xiaodi112/----home--valve/Pressure_Regulating_Box/Projects/Wakeup_box_V0.0.1/readme.txt

/*!
    \file    readme.txt
    \brief   description of the LPUART wakeup from deepsleep

    \version 2025-08-21, V2.5.0, demo for GD32L23x
*/

/*
    Copyright (c) 2025, GigaDevice Semiconductor Inc.

    Redistribution and use in source and binary forms, with or without modification,
are permitted provided that the following conditions are met:

    1. Redistributions of source code must retain the above copyright notice, this
       list of conditions and the following disclaimer.
    2. Redistributions in binary form must reproduce the above copyright notice,
       this list of conditions and the following disclaimer in the documentation
       and/or other materials provided with the distribution.
    3. Neither the name of the copyright holder nor the names of its contributors
       may be used to endorse or promote products derived from this software without
       specific prior written permission.

    THIS SOFTWARE IS PROVIDED BY THE COPYRIGHT HOLDERS AND CONTRIBUTORS "AS IS"
AND ANY EXPRESS OR IMPLIED WARRANTIES, INCLUDING, BUT NOT LIMITED TO, THE IMPLIED
WARRANTIES OF MERCHANTABILITY AND FITNESS FOR A PARTICULAR PURPOSE ARE DISCLAIMED.
IN NO EVENT SHALL THE COPYRIGHT HOLDER OR CONTRIBUTORS BE LIABLE FOR ANY DIRECT,
INDIRECT, INCIDENTAL, SPECIAL, EXEMPLARY, OR CONSEQUENTIAL DAMAGES (INCLUDING, BUT
NOT LIMITED TO, PROCUREMENT OF SUBSTITUTE GOODS OR SERVICES; LOSS OF USE, DATA, OR
PROFITS; OR BUSINESS INTERRUPTION) HOWEVER CAUSED AND ON ANY THEORY OF LIABILITY,
WHETHER IN CONTRACT, STRICT LIABILITY, OR TORT (INCLUDING NEGLIGENCE OR OTHERWISE)
ARISING IN ANY WAY OUT OF THE USE OF THIS SOFTWARE, EVEN IF ADVISED OF THE POSSIBILITY
OF SUCH DAMAGE.
*/

  This example is based on the GD32L233R-EVAL-V1.1 board, it shows how to use the LPUART
to wake up the MCU from deepsleep mode.
  In this demo, the wake up method is configured as start bit detection. When the MCU
enters into deepsleep mode, the LED1 stops in a certain status(on or off). In this 
case, you can send some characters to wake up LPUART and the LED1 blinks.
