xiaodi112/----home--valve/docs/工程架构整理.md

# 工程架构整理与改动指南

> 适用工程：`Pressure_Regulating_Box`（GD32L233RC，Keil MDK）
> 最后更新：2026-08-28（对应激光甲烷/定时开关阀/三组独立 I2C 重构后的代码状态）

---

## 1. 总体架构

### 1.1 分层与依赖方向

```
App（业务层：不碰寄存器/外设）
  │  只调用 Middle 接口 与 BSP 语义接口
  ▼
Middle（中间层：业务编排、协议、配置、上报）
  │  调用 Drivers / BSP
  ▼
Drivers（外设驱动：通信/传感器/存储传输）
  │  调用 BSP（延时、串口、电源）
  ▼
BSP（板级驱动：GPIO/电源/电机/LCD/深睡，自包含、零业务依赖）
```

**强制约定**：
- App 层不得出现 `gpio_*`、`rcu_*`、`pwm_*` 直接调用（main.c 启动段除外）。
- BSP 层不得 include Middle/App 头文件、不得引用业务全局变量。
- 平台 JSON 组包只能出现在 `Middle/report.c`。
- 各层向下依赖，禁止反向。

### 1.2 目录与模块职责

#### App（业务层）

| 模块 | 职责 | 说明 |
|---|---|---|
| `valve.c/h` | 阀门业务：开/关/状态查询、到位超时、压紧延时、状态持久化 | 只调 motor 语义接口，无 GPIO |
| `lcd_ui.c/h` | LCD 页面/图标、蓝牙开关 | 蓝牙电源走 `power_ble_set()` |
| `buzzer.c/h` | 蜂鸣器提示音 | 调 output API |
| `led.c/h` | LED 指示 | 调 output API |

#### Middle（中间层）

| 模块 | 职责 |
|---|---|
| `main.h` | 主模块接口：`g_sensor`、`lcd_shutdown`、`alarm_try_close_valve` |
| `report.c/h` | **统一上报唯一出口**：`report_publish_field/feedback/ip_field/sensor_status/upload_summary`、`report_query_signal_info` |
| `downlink.c/h` | 下行指令：`parse_cmd` 解析 + `s_cmd_handlers` 表驱动分发；对外仅 `drain_pending_downlink()` |
| `eeprom_config.h` | 配置门面头：EEPROM 地址、结构体、全局 extern、接口声明 |
| `config_store.c/h` | 配置持久化：EE 读写、`config_load_all`、`config_save_*`；**全局 g_\* 定义归属** |
| `config_policy.c/h` | 配置纯策略：dottime 位图、周期/异常转换、窗口/采集决策 |
| `eeprom_config.c` | 配置 CLI：串口命令解析、上电配置等待、配置打印 |
| `app_config.h` | 编译期业务默认值（周期/窗口/阈值/协议参数、IIC0/1/2 总线映射） |
| `threshold.c/h` | 阈值判断（纯业务，只读配置结构体） |
| `valve_timing.c/h` | 定时开关阀时间匹配（纯逻辑，无硬件依赖；closeoropen_set/get） |
| `ch4_alarm.c/h` | 激光甲烷状态机（`do_ch4()` 入口）+ 阈值判断 |
| `json_builder.c/h` | 轻量 JSON 构建器 |
| `ota_app.c/h` | OTA 应用流程（4G 下载→缓存→InfoBlock→重启） |
| `eeprom_history.c/h` | 历史数据存取 |
| `sensor_record.h` / `ota_info.h` | 数据/Flash 布局定义 |

#### BSP（板级驱动，自包含）

| 模块 | 职责 | 关键接口 |
|---|---|---|
| `power.c/h` | 电源管理：4G_EN、BLE_EN、传感器供电(SENSOR_PWR PC3)、CH4_PWR(PC13)、DTR | `power_gpio_init`、`power_4g_set/is_on`、`power_ble_set`、`power_sensor_set`、`power_ch4_set/is_on`、`power_4g_dtr_set` |
| `output.c/h` | 蜂鸣器/LED 输出 | `output_gpio_init`、`output_buzzer_set`、`output_led_set/is_on` |
| `motor.c/h` | 电机：限位、方向、使能、引脚宏(`MOTOR_ENABLED=0` 时空实现) | `motor_init(enabled)`、`motor_drive_open/close`、`motor_stop`、`motor_limit1/2_reached`、`motor_sleep_enable/disable` |
| `usart.c/h` | USART0(Debug)/USART1(CH4)/LPUART0(4G)/UART4(BLE)：初始化、DMA、打印 | `printf_debug`、`debug_rx_read_line`、`com_lpuart_init`、`usart1_ch4_init/deinit`、`ble_uart_init` |
| `wakeup.c/h` | 深睡入口/唤醒重初始化 | `enter_deepsleep_mode(PmSleepCfg_t*)`、`system_wakeup_reinit` |
| `mygpio.c/h` | GPIO 初始化、按键 EXTI、低功耗引脚归位、唤醒源 | `gpio_init`、`gpio_enter_low_power(lpuart,lcd,bt)`、`button_*`、`ble_exti_*`、`ri_exti_*` |
| `tim.c/h` | RTC 时间/闹钟 | `rtc_get_hhmmss`、`rtc_set_next_alarm_sec` |
| `delay.c/h` | 延时 + 软件看门狗 | `trea_delay_ms`、`trea_millis`、`swdt_enable/disable` |
| `systick.c/h` | 系统滴答 | — |
| `adc_bat.c/h` | 电池电压 | `adc_bat_read_voltage` |
| `slcd_seg.c/h` | 段码 LCD 底层 + 关屏释放引脚 | `slcd_seg_*`、`slcd_shutdown` |

#### Drivers（外设驱动，**仍待净化**）

| 模块 | 职责 | 遗留问题（主题 B） |
|---|---|---|
| `soft_i2c.c/h` | 软件 I2C（三组独立总线 IIC0=PB6/7 EEPROM、IIC1=PD4/5 S2、IIC2=PC0/1 S1）+ 传感器供电调用 | 引脚宏仍来自 app_config.h（IIC0/1/2 宏） |
| `ec800e.c/h` | 4G AT/MQTT/HTTP | 仍含 FastBee JSON、`FullUpload` 编排、依赖业务头 |
| `ble_ota.c/h` | BLE OTA 协议 | 仍含 `YLY_<ID>` 名称配置等业务 |
| `PT_304_35.c/h` | 压力/温度传感器（S1=低压/出气→IIC2，S2=中压/进气→IIC1） | — |
| `ch4_sensor.c/h` | 激光甲烷传感器驱动（USART1，独立、可移植、零上层依赖） | — |
| `m24m01.c/h`、`at24c64.c/h` | EEPROM 芯片驱动（当前启用 AT24C64，走 IIC0 PB6/7 独立总线） | — |

#### 顶层

| 文件 | 职责 |
|---|---|
| `Projects/.../main.c` | 主状态机编排、启动初始化、休眠/唤醒、4G 策略、调试命令 |
| `Projects/.../gd32l23x_it.c` | 中断服务（仅置唤醒标志，不处理业务） |
| `Bootloader/boot_main.c` | 启动引导 + OTA 搬运 |

---

## 2. 核心设计约定

### 2.1 主状态机（main.c）

```
STATE_INIT → STATE_SLEEP → STATE_WAKEUP ─┬→ STATE_COLLECT → STATE_UPLOAD
                  ↑                       ├→ STATE_DOWNLINK
                  │                       ├→ STATE_ALARM
                  │                       ├→ STATE_BLE_OTA
                  │                       └→ STATE_CH4
                  └─────────────────────────────────────────┘
```

- 深睡：`wakeup.c` 统一入口，唤醒源 = RTC 闹钟 / LPUART / 按键 EXTI / 4G RI。
- 入睡前由 main.c 组装 `PmSleepCfg_t{lpuart_enabled, lcd_active, bt_on}` 传给 BSP，BSP 不读全局。
- `STATE_CH4`：激光甲烷采集,由 `g_ch4_request`(`gas_get` 触发)或 `laser_time` 位图命中整点时,在主循环 `STATE_SLEEP` 分支转入;不抢占网格采集/整点上报。

### 2.2 下行指令流程（downlink.c）

```
EC801E_ReadDownlink → parse_cmd(raw, &req)
   ├─ OTA（含 downloadUrl）→ ota_app_handle_upgrade_cmd
   ├─ 格式B（commandStr）→ CmdMap 映射为 id
   └─ 格式A（id/value）
        ↓
s_cmd_handlers 表（44 项，含 gas_get/laser_get/laser_set/msh_get/msh_set/closeoropen_*/table_*）→ h_xxx(id_val, cmd_val, raw_buf)
        ↓
report_publish_*（反馈/响应）
```

`s_cmd_map`（commandStr → id 映射）当前 47 项；`s_cmd_handlers`（id → handler 分发）当前 44 项。

### 2.3 上报（report.c）

- 平台 JSON 组包唯一出口，`EC801E_PublishRawJson` 只被 report.c 直接调用（驱动内部除外）。
- 模块内共享 1KB 缓冲 + 32B 时间戳，函数串行使用、禁止嵌套。

### 2.4 配置（eeprom_config.h 门面 + 三实现文件）

- **数据**：地址/magic/结构体/全局 extern/接口声明 → `eeprom_config.h`
- **持久化**：`config_store.c`（全局 g_\* 定义 + 读写 + load/save，含 `config_save_valve_timing/ch4_threshold/laser`）
- **策略**：`config_policy.c`（纯逻辑，无 EEPROM/串口）
- **CLI**：`eeprom_config.c`（串口解析 + 上电等待）

EEPROM 区块新增：定时开关阀(0xC8/0x490)、CH4 阈值(0xC9/0x4B0)、激光定时采集(0xCA/0x4C0)。芯片由 `app_config.h` 编译宏二选一(当前 `EEPROM_DRV_AT24C64` 8KB)，均走 IIC0(PB6/7)独立总线。

### 2.5 编码规则（重要）

- 工作区 `.c/.h` 为 **GBK**；入库时经 `.gitattributes`（`working-tree-encoding=GBK`）自动转 UTF-8。
- `docs/*.md` 为 UTF-8。
- 修改 `.c/.h` 时：若文件含中文注释，编辑后必须保持 GBK（可用 GBK→UTF-8 编辑→转回，或字节级 ASCII 替换）；`git diff` 若显示中文乱码说明编码被破坏。
- 新文件同样要转 GBK（纯 ASCII 内容则两种编码等价）。

### 2.6 低功耗

- 深睡路径统一走 `enter_deepsleep_mode()`：清唤醒标志 → 关软狗 → `gpio_enter_low_power`（未用引脚全 Analog）→ PMU 深睡 → 等唤醒源。
- 4G 省电：QSCLK/DTR（power.c）；弱信号自动断电（main.c 策略）。

---

## 3. 日常改动指南

### 3.1 新增一条 MQTT 下行指令

1. （格式B）在 `downlink.c` 的 `s_cmd_map` 增加 `commandStr → id` 映射；若平台用格式A（id/value），跳过此步。
2. 在 `downlink.c` 写 handler：
   ```c
   static void h_my_cmd(const char *id_val, const char *cmd_val, const char *raw_buf)
   {
       /* 业务逻辑；参数/响应用 report_publish_* */
   }
   ```
3. 在 `s_cmd_handlers[]` 登记：`{ "my_id", h_my_cmd },`（格式A 的 id 直接命中；格式B 经 CmdMap 归一后命中）。
4. 反馈用 `report_publish_feedback(码)`，单字段响应用 `report_publish_field/response`。
5. 编译 + 用平台下发验证。

### 3.2 新增/修改上报字段

- 只改 `Middle/report.c`（字段名、格式、缓冲）。
- 若需要新上报函数，加到 `report.h` 并保持"串行使用共享缓冲"约定。

### 3.3 新增配置项

1. 结构体字段：`eeprom_config.h`（配置结构体）。
2. 存储布局：`eeprom_config.h` 增加地址宏 + magic（注意区域不重叠）。
3. 读写：`config_store.c` 的 `config_load_all` / `config_save_*`。
4. 默认值：`app_config.h` 或 `eeprom_config.h` 的 `DEF_*`。
5. CLI 解析：`eeprom_config.c` 的 `parse_*` / `config_parse_and_apply`。
6. 平台指令：按 3.1 流程加 handler。

### 3.4 新增 BSP 模块 / 改引脚

- 引脚宏定义在**模块自己的头文件**（如 motor.h、power.h），不要放 app_config.h。
- BSP 模块不得 include Middle/App 头；需要的状态由调用方传参。
- 新增 `.c/.h` 后必须在 Keil 工程 `GD32L233R_EVAL.uvprojx` 对应组登记。

### 3.5 修改电机/LCD/4G 行为

- 电机：只改 `BSP/motor.c`（语义接口内部）；`App/valve.c` 不感知 PWM/GPIO 差异。
- LCD：显示逻辑在 `App/lcd_ui.c`，底层/关屏在 `BSP/slcd_seg.c`。
- 4G 电源/休眠：`BSP/power.c` + `main.c` 策略；AT/协议在 Drivers（待主题 B 拆分）。

---

## 4. 已完成重构记录

| 批次 | 内容 | 验证 |
|---|---|---|
| 1 | motor 语义接口 + valve 去寄存器；pwm_compute/占空比钳制/关阀停车修复 | 构建 0/0 |
| 2 | 新增 power/output/wakeup；业务层去 GPIO；mygpio/usart 去业务全局；板级宏归位 | 构建 0/0 |
| 3 | report.c 统一上报，消灭 main/downlink 重复组包 | 构建 0/0，省 736B RAM |
| 4 | downlink 表驱动（36 handler + 39 表项）；parse_cmd 统一解析去 hack；eeprom_config 三拆 | 构建 0/0 |
| 5 | 激光甲烷传感器(ch4_sensor/ch4_alarm + STATE_CH4 + USART1/PC13)；定时开关阀(valve_timing + EEPROM 0xC8)；三组独立 I2C(IIC0=PB6/7 EEPROM / IIC1=PD4/5 S2 / IIC2=PC0/1 S1) + PC3 传感器供电；EEPROM 切换 AT24C64；downlink 表增至 47 map/44 handler | 构建 0/0 |

---

## 5. 已知遗留问题（待办）

| 主题 | 问题 | 建议 |
|---|---|---|
| B | `ec800e.c` 仍混业务：FastBee JSON、`FullUpload` 编排、依赖 `eeprom_config/threshold/main` 头 | 拆 `ec_at` 传输层 + MQTT 客户端，JSON 组包并入 report.c |
| B | `ble_ota.c` 含 `YLY_<ID>` 名称配置业务 | 业务参数化上移 |
| E | `g_sensor` 等全局仍跨模块共享 | 收敛到 `sensor.c` 模块 + 接口函数 |
| F | downlink 各 handler 内 300ms 延时、`first_ip_set` 重连阻塞 | 反馈并入回复 JSON / 下轮补发；重连异步化 |
| F | 阀门 20s 阻塞等待（**用户已搁置，需另行通知**） | 限位轮询 + 超时状态机 |
| — | IIC0/1/2 引脚宏仍定义在 `app_config.h`（soft_i2c.h / at24c64.h / PT_304_35.h 依赖） | 后续移入 BSP 板级头 |
| — | `report_publish_upload_summary` 的 `user_state` 静态标志（用户 MQTT 凭据仅首次上报） | 确认语义或改为配置版本号触发 |
| ✓ | `docs/project.md` §12 文件结构(旧 my_Library 时代) | 已于 2026-08-28 按 App/Middle/BSP/Drivers 四层重写 |

---

## 6. 构建与验证

### 6.1 命令行构建（Keil UV4）

```powershell
& 'D:/keil/core/UV4/UV4.exe' -b "Pressure_Regulating_Box/Projects/Wakeup_box_V0.0.1/MDK-ARM/GD32L233R_EVAL.uvprojx" -o build.log -j0
```

要求：**0 Error / 0 Warning**；关注 `Program Size` 的 `ZI-data`（SRAM 用量）。

### 6.2 回归清单（入口）

- 串口命令：`status / sensor / sim / config / valve:open / valve:close / threshold_get / restart / reset` 等（详见 `docs/project.md` §8）。
- 平台下发：查询/设置指令 + feedback 码核对。
- 专项：深睡唤醒、定时阀、异常关阀、OTA、功耗。

### 6.3 提交规范

- 分支前缀 `codex/`；一个主题一个 commit；每个 commit 必须可编译。
- message 沿用仓库风格：`feat/fix/refactor + 中文摘要 + 动机/影响正文`。
- 提交前检查 `git diff` 无编码乱码。

---

## 7. 快速索引

- 主流程/状态机：`Projects/Wakeup_box_V0.0.1/main.c`
- 平台上报格式：`Middle/report.c`
- 下行指令表：`Middle/downlink.c`（`s_cmd_map` + `s_cmd_handlers`）
- 配置存储布局：`Middle/eeprom_config.h`；持久化 `config_store.c`；策略 `config_policy.c`；CLI `eeprom_config.c`
- 引脚：`BSP/power.h`、`BSP/output.h`、`BSP/motor.h`、`Middle/app_config.h`（IIC）、`docs/引脚使用情况说明.md`
- 深睡/唤醒：`BSP/wakeup.c`
