xiaodi112/----home--valve/Pressure_Regulating_Box/LCD.png

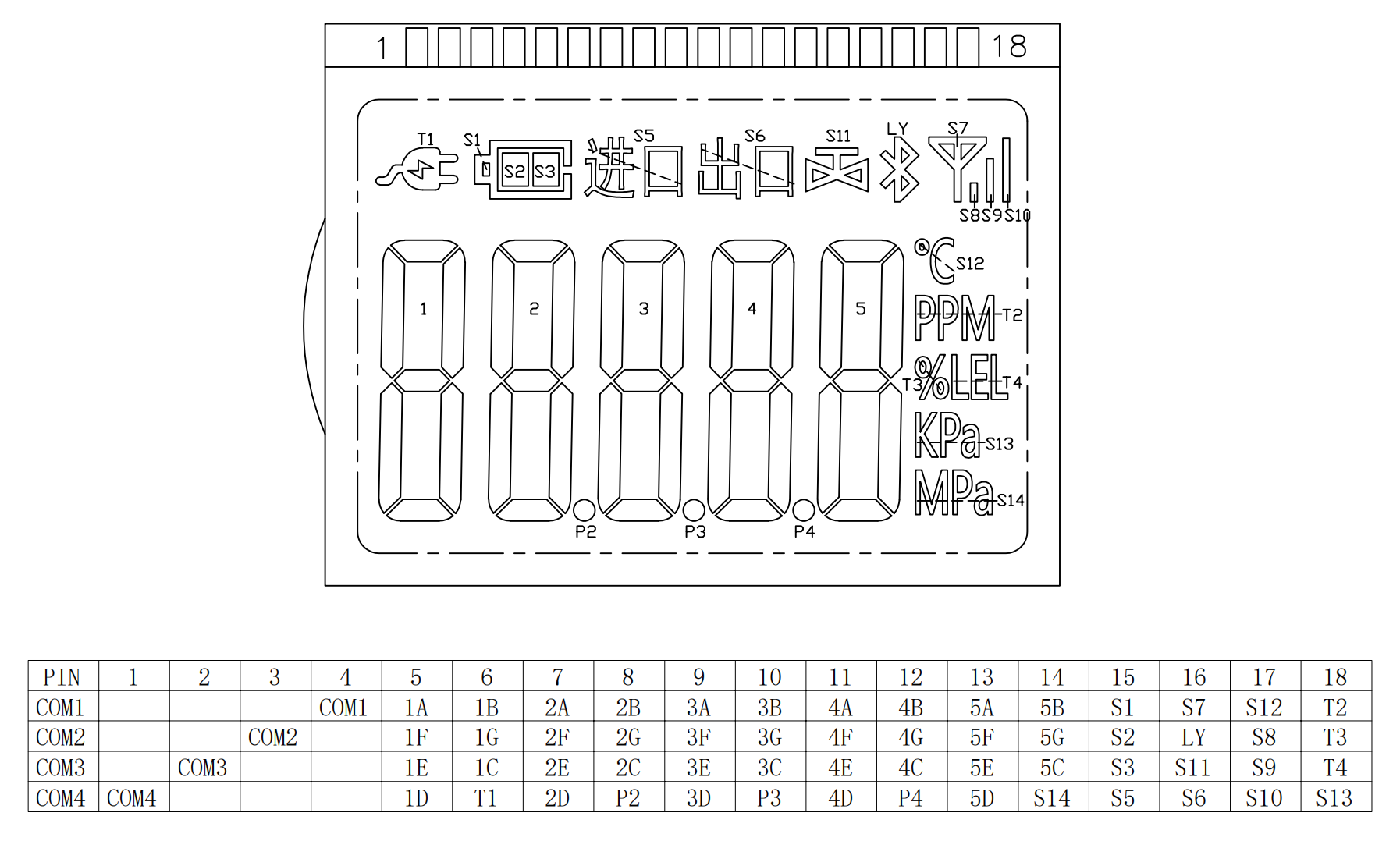
Pressure_Regulating_Box/LCD.png
