xiaodi112/----home--valve/Pressure_Regulating_Box/数据交互.png

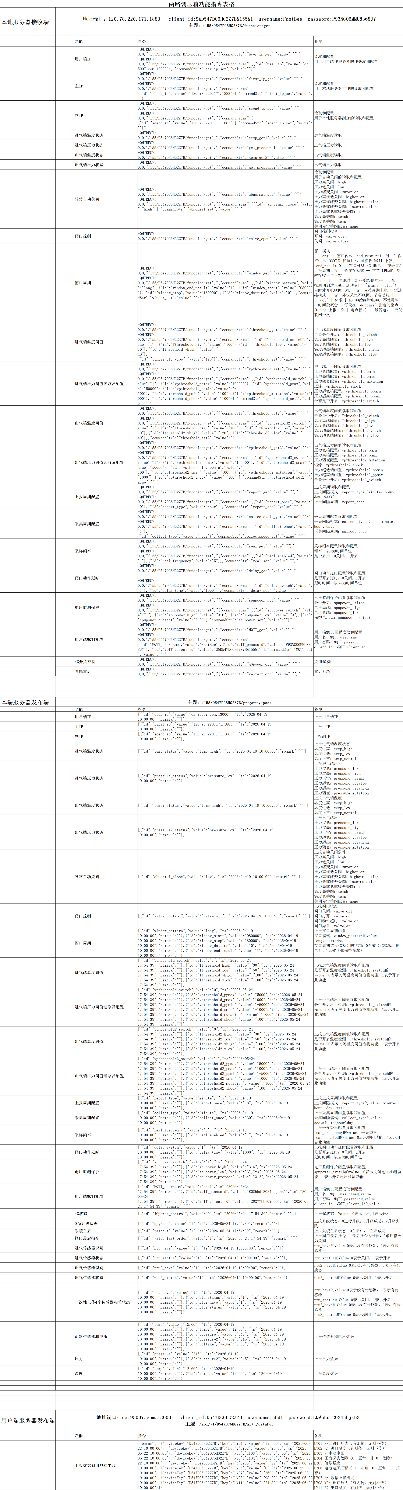
Pressure_Regulating_Box/数据交互.png
