xiaodi112/----home--valve/Pressure_Regulating_Box/电路图.png

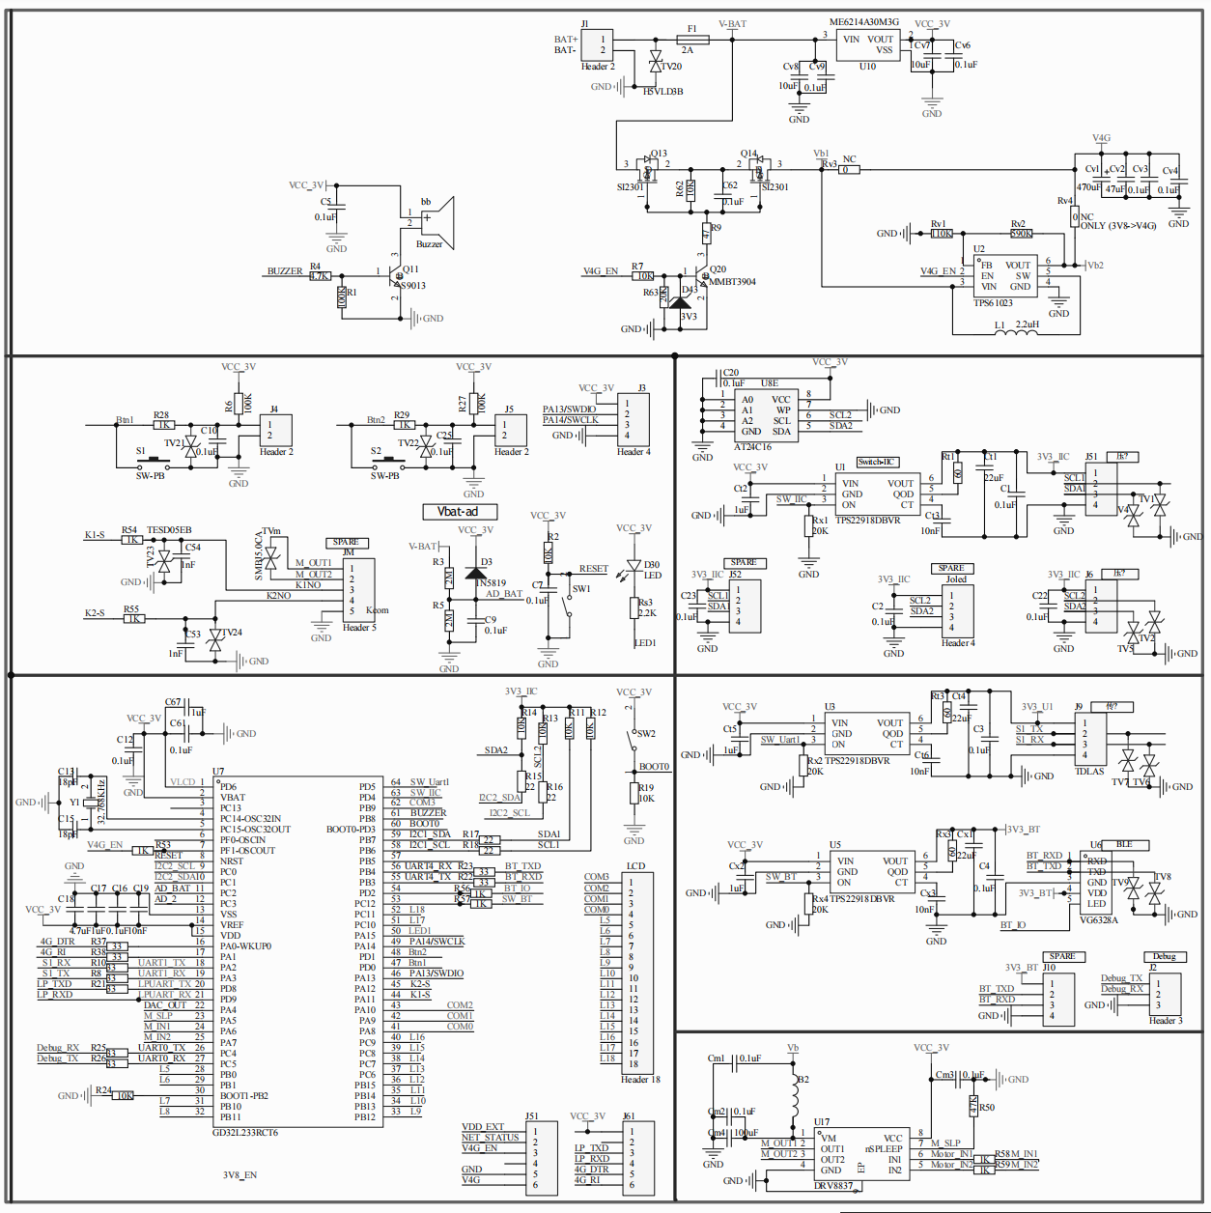
Pressure_Regulating_Box/电路图.png
