xiaodi112/----home--valve/Household_valves_LPUART_OTA/Projects/07_LPUART_Deepsleep_Wakeup/MDK-ARM/build_log.txt

*** Using Compiler 'V6.24', folder: 'D:\keil\core\ARM\ARMCLANG\Bin'
Rebuild target 'GD32L233R_EVAL'
compiling system_gd32l23x.c...
compiling gd32l23x_it.c...
compiling main.c...
compiling systick.c...
compiling boot_main.c...
compiling app_vectors.c...
compiling gd32l23x_cau_tdes.c...
compiling gd32l23x_cau_des.c...
compiling i2c_cz.c...
compiling gd32l23x_cau.c...
compiling gd32l23x_cau_aes.c...
compiling gd32l23x_adc.c...
compiling gd32l23x_crc.c...
compiling gd32l23x_cmp.c...
compiling gd32l23x_ctc.c...
compiling gd32l23x_dac.c...
compiling gd32l23x_dbg.c...
compiling gd32l23x_exti.c...
compiling gd32l23x_fwdgt.c...
compiling gd32l23x_gpio.c...
compiling gd32l23x_lptimer.c...
compiling gd32l23x_dma.c...
compiling gd32l23x_fmc.c...
compiling gd32l23x_i2c.c...
compiling gd32l23x_misc.c...
compiling gd32l23x_lpuart.c...
compiling gd32l23x_pmu.c...
compiling gd32l23x_rcu.c...
compiling gd32l23x_rtc.c...
assembling startup_gd32l233.s...
compiling gd32l23x_slcd.c...
compiling gd32l23x_syscfg.c...
compiling gd32l23x_trng.c...
compiling gd32l23x_spi.c...
compiling gd32l23x_vref.c...
compiling gd32l23x_wwdgt.c...
compiling gd32l233r_eval.c...
compiling gd32l23x_usart.c...
compiling gd32l23x_timer.c...
compiling ec800e.c...
compiling usart.c...
compiling delay.c...
compiling tim.c...
compiling AT24c16.c...
compiling sensor_buffer.c...
compiling mygpio.c...
compiling PT_304_35.c...
compiling motor.c...
compiling myi2c.c...
compiling adc_bat.c...
compiling ota.c...
compiling threshold.c...
compiling eeprom_config.c...
linking...
Program Size: Code=58318 RO-data=14082 RW-data=12 ZI-data=22636  
FromELF: creating hex file...
".\Objects\Project.axf" - 0 Error(s), 0 Warning(s).
Build Time Elapsed:  00:00:03
