xiaodi112/----home--valve/Pressure_Regulating_Box/change log.txt

/*!
    \file    change log.txt
    \brief   change log for GD32L23x demo

    \version 2025-08-21, V2.5.0, demo for GD32L23x
*/

/*
    Copyright (c) 2025, GigaDevice Semiconductor Inc.

    Redistribution and use in source and binary forms, with or without modification,
are permitted provided that the following conditions are met:

    1. Redistributions of source code must retain the above copyright notice, this
       list of conditions and the following disclaimer.
    2. Redistributions in binary form must reproduce the above copyright notice,
       this list of conditions and the following disclaimer in the documentation
       and/or other materials provided with the distribution.
    3. Neither the name of the copyright holder nor the names of its contributors
       may be used to endorse or promote products derived from this software without
       specific prior written permission.

    THIS SOFTWARE IS PROVIDED BY THE COPYRIGHT HOLDERS AND CONTRIBUTORS "AS IS"
AND ANY EXPRESS OR IMPLIED WARRANTIES, INCLUDING, BUT NOT LIMITED TO, THE IMPLIED
WARRANTIES OF MERCHANTABILITY AND FITNESS FOR A PARTICULAR PURPOSE ARE DISCLAIMED.
IN NO EVENT SHALL THE COPYRIGHT HOLDER OR CONTRIBUTORS BE LIABLE FOR ANY DIRECT,
INDIRECT, INCIDENTAL, SPECIAL, EXEMPLARY, OR CONSEQUENTIAL DAMAGES (INCLUDING, BUT
NOT LIMITED TO, PROCUREMENT OF SUBSTITUTE GOODS OR SERVICES; LOSS OF USE, DATA, OR
PROFITS; OR BUSINESS INTERRUPTION) HOWEVER CAUSED AND ON ANY THEORY OF LIABILITY,
WHETHER IN CONTRACT, STRICT LIABILITY, OR TORT (INCLUDING NEGLIGENCE OR OTHERWISE)
ARISING IN ANY WAY OUT OF THE USE OF THIS SOFTWARE, EVEN IF ADVISED OF THE POSSIBILITY
OF SUCH DAMAGE.
*/

******************* V2.5.0 2025-08-21 ************************************************************************************
______________________Common______________________________________________________________________________________________
Fix file:
..\GD32L23x_Firmware_Library
fix reason:
Update the firmware library version from V2.2.0 to V2.3.0.
__________________________________________________________________________________________________________________________
******************* V2.4.0 2025-02-18 ************************************************************************************
______________________Common______________________________________________________________________________________________
Fix file:
all IAR project.
fix reason:
Update IAR project format(modify default .board/mac/ddf/icf linker path).
__________________________________________________________________________________________________________________________
______________________Common______________________________________________________________________________________________
Fix file:
..\GD32L23x_Firmware_Library
fix reason:
Update the firmware library version from V2.1.0 to V2.2.0.
__________________________________________________________________________________________________________________________

******************* V2.3.0 2024-11-04 ************************************************************************************
______________________Common______________________________________________________________________________________________
Fix file:
..\GD32L23x_Firmware_Library
fix reason:
Update the firmware library version from V2.0.2 to V2.1.0.
__________________________________________________________________________________________________________________________

______________________Common______________________________________________________________________________________________
Fix file:
../Projects/08_ADC_Temperature_Vrefint/main.c
../Projects/15_CAU/main.c
../Projects/14_TRNG_Get_Random/main.c
fix reason:
Compatible with GCC compilation environment.
V2.2.0:
/* retarget the C library printf function to the USART */
int fputc(int ch, FILE *f)
{
    usart_data_transmit(EVAL_COM, (uint8_t)ch);
    while(RESET == usart_flag_get(EVAL_COM, USART_FLAG_TBE));

    return ch;
}
V2.3.0:
#ifdef GD_ECLIPSE_GCC
/* retarget the C library printf function to the USART, in Eclipse GCC environment */
int __io_putchar(int ch)
{
   usart_data_transmit(EVAL_COM, (uint8_t) ch );
    while(RESET == usart_flag_get(EVAL_COM, USART_FLAG_TBE));
    return ch;
}
#else
/* retarget the C library printf function to the USART */
int fputc(int ch, FILE *f)
{
    usart_data_transmit(EVAL_COM, (uint8_t)ch);
    while(RESET == usart_flag_get(EVAL_COM, USART_FLAG_TBE));

    return ch;
}
#endif /* GD_ECLIPSE_GCC */
__________________________________________________________________________________________________________________________
