xiaodi112/----home--valve/Pressure_Regulating_Box/Projects/Wakeup_box_V0.0.1/MDK-ARM/my_Library/mygpio.c

#include "mygpio.h"
#include "eeprom_config.h"
#include "lcd_ui.h"



void gpio_init(void)
{
    rcu_periph_clock_enable(RCU_GPIOA);
    rcu_periph_clock_enable(RCU_GPIOB);
    rcu_periph_clock_enable(RCU_GPIOC);
    rcu_periph_clock_enable(RCU_GPIOD);
    rcu_periph_clock_enable(RCU_GPIOF);

    /* 先写 ODR 再切输出模式, 避免模式切换瞬间的电平跳变:
     *   PA0(4G_DTR):  默认 HIGH (允许 EC800E 休眠)
     *   PA15(LED1):   默认 LOW (LED 默认息灭)
     *   PB8(BUZZER):  默认 LOW (蜂鸣器默认关闭)
     *   PC12(SW_BT 蓝牙开关): 默认 LOW (蓝牙默认断电)
     *   PD4(SW_IIC 电子开关): 默认 LOW (节能, 采集时按需上电)
     *   PB5(V4G_EN 4G 电源): 默认 LOW (4G 默认断电)
     */

    gpio_mode_set(GPIOA, GPIO_MODE_OUTPUT, GPIO_PUPD_NONE, GPIO_PIN_0);
    gpio_output_options_set(GPIOA, GPIO_OTYPE_PP, GPIO_OSPEED_2MHZ, GPIO_PIN_0);
	gpio_bit_set(GPIOA, GPIO_PIN_0);

    gpio_mode_set(GPIOB, GPIO_MODE_OUTPUT, GPIO_PUPD_NONE, GPIO_PIN_8);
    gpio_output_options_set(GPIOB, GPIO_OTYPE_PP, GPIO_OSPEED_2MHZ, GPIO_PIN_8);

    gpio_mode_set(GPIOC, GPIO_MODE_OUTPUT, GPIO_PUPD_NONE, GPIO_PIN_12);
    gpio_output_options_set(GPIOC, GPIO_OTYPE_PP, GPIO_OSPEED_2MHZ, GPIO_PIN_12);

    gpio_mode_set(GPIOD, GPIO_MODE_OUTPUT, GPIO_PUPD_NONE, GPIO_PIN_4);
    gpio_output_options_set(GPIOD, GPIO_OTYPE_PP, GPIO_OSPEED_2MHZ, GPIO_PIN_4);

    gpio_mode_set(GPIOB, GPIO_MODE_OUTPUT, GPIO_PUPD_NONE, GPIO_PIN_5);
    gpio_output_options_set(GPIOB, GPIO_OTYPE_PP, GPIO_OSPEED_2MHZ, GPIO_PIN_5);
}

// ===================== PD0(Btn1)/PD1(Btn2) 按键唤醒 =====================
volatile uint8_t button_wakeup_flag = 0;

// 深休眠前调用: PD0输入+上拉 → EXTI0下降沿 → NVIC使能
void button_exti_init(void)
{
    rcu_periph_clock_enable(RCU_GPIOD);
    rcu_periph_clock_enable(RCU_SYSCFG);

    // PD0(Btn1)/PD1(Btn2): 输入, 内部上拉 (空闲HIGH, 按下LOW)
    gpio_mode_set(GPIOD, GPIO_MODE_INPUT, GPIO_PUPD_NONE, GPIO_PIN_0);

    // EXTI0 → PD0(Btn1), 下降沿触发唤醒
    syscfg_exti_line_config(EXTI_SOURCE_GPIOD, EXTI_SOURCE_PIN0);
    exti_init(EXTI_0, EXTI_INTERRUPT, EXTI_TRIG_FALLING);
    exti_flag_clear(EXTI_0);

    // NVIC使能 EXTI0 独立中断
    nvic_irq_enable(EXTI0_IRQn, 2);

    button_wakeup_flag = 0;
}

// 唤醒后调用: 禁用EXTI0 + 清标志, 防止抖动重复触发
void button_exti_disable(void)
{
    exti_interrupt_disable(EXTI_0);
    exti_flag_clear(EXTI_0);
    nvic_irq_disable(EXTI0_IRQn);
}

// 读取PD0(Btn1)电平: 1=按下(LOW), 0=松开(HIGH)
uint8_t button_is_pressed(void)
{
    return (gpio_input_bit_get(GPIOD, GPIO_PIN_0) == RESET) ? 1 : 0;
}

// ===================== 极低功耗休眠配置 =====================
// 将休眠期间不需要的GPIO配置为 Analog Input (不带上下拉)，彻底杜绝引脚倒灌和悬空漏电
void gpio_enter_low_power(uint8_t lpuart_enabled)
{
    /* 1. 确保所有GPIO时钟开启以允许配置其寄存器 */
    rcu_periph_clock_enable(RCU_GPIOA);
    rcu_periph_clock_enable(RCU_GPIOB);
    rcu_periph_clock_enable(RCU_GPIOC);
    rcu_periph_clock_enable(RCU_GPIOD);
    rcu_periph_clock_enable(RCU_GPIOF);

    /* 2. GPIOA 配置
     *    排除 PA8/PA9/PA10 (SLCD COM0/COM1/COM2, LCD开启时保持AF)
     */
    uint32_t gpioa_analog_pins = GPIO_PIN_0 | GPIO_PIN_1 | GPIO_PIN_2 | GPIO_PIN_3 | GPIO_PIN_4 |
                                 GPIO_PIN_5 | GPIO_PIN_6 | GPIO_PIN_7 |
                                 GPIO_PIN_11 | GPIO_PIN_12 | GPIO_PIN_15;
    if(!g_lcd_active)
        gpioa_analog_pins |= (GPIO_PIN_8 | GPIO_PIN_9 | GPIO_PIN_10);  /* PA8-10: SLCD COM0-2 */
    gpio_mode_set(GPIOA, GPIO_MODE_ANALOG, GPIO_PUPD_NONE, gpioa_analog_pins);

    /* 3. GPIOB 配置
     *    排除 PB0/PB1 (SLCD SEG5/6), PB9 (SLCD COM3), PB10-PB15 (SLCD SEG10-15) — LCD开启时
     *    排除 PB3/PB4 (UART4_TX/RX) — 蓝牙开启时保持AF
     */
    uint32_t gpiob_analog_pins = GPIO_PIN_2 | GPIO_PIN_6 | GPIO_PIN_7 | GPIO_PIN_8;
    if(!g_bt_on)
        gpiob_analog_pins |= (GPIO_PIN_3 | GPIO_PIN_4);  /* 蓝牙关闭时PB3/PB4转Analog */
    if(!g_lcd_active)
        gpiob_analog_pins |= (GPIO_PIN_0 | GPIO_PIN_1 | GPIO_PIN_9 |
                              GPIO_PIN_10 | GPIO_PIN_11 | GPIO_PIN_12 |
                              GPIO_PIN_13 | GPIO_PIN_14 | GPIO_PIN_15);  /* SLCD SEG+COM3 */
    gpio_mode_set(GPIOB, GPIO_MODE_ANALOG, GPIO_PUPD_NONE, gpiob_analog_pins);

    /* 4. GPIOC 配置
     *    排除 PC6-PC11 (SLCD SEG24-29, LCD开启时保持AF)
     *    排除 PC12 (SW_BT 输出)
     *    排除 PC14/PC15 (LXTAL, RTC保持, 绝对不动!)
     */
    uint32_t gpioc_analog_pins = GPIO_PIN_0 | GPIO_PIN_1 | GPIO_PIN_2 | GPIO_PIN_3 | 
                                 GPIO_PIN_4 | GPIO_PIN_5 | 
                                 GPIO_PIN_13;
    if(!g_lcd_active)
    {
        gpioc_analog_pins |= (GPIO_PIN_6 | GPIO_PIN_7 | GPIO_PIN_8 |
                              GPIO_PIN_9 | GPIO_PIN_10 | GPIO_PIN_11);  /* SLCD SEG24-29 */
        rcu_periph_clock_disable(RCU_SLCD);  /* 关闭SLCD外设时钟 */
    }
    gpio_mode_set(GPIOC, GPIO_MODE_ANALOG, GPIO_PUPD_NONE, gpioc_analog_pins);

    /* 5. GPIOD 配置
     *    PD0(Btn1): 按键唤醒 EXTI0, 保持 INPUT (外部上拉)
     *    PD1(Btn2): 保持 INPUT (外部上拉, 防悬空)
     *    PD4(SW_IIC): gpio_init 已配置为 OUTPUT LOW (电子开关断电), 跳过
     *    PD8=LPUART0_TX, PD9=LPUART0_RX: LPUART启用时保留 AF
     */
    uint32_t gpiod_analog_pins = GPIO_PIN_3 | GPIO_PIN_4 |
                                 GPIO_PIN_5 | GPIO_PIN_6 | GPIO_PIN_7 |
                                 GPIO_PIN_10 | GPIO_PIN_11 | GPIO_PIN_12 | GPIO_PIN_13 |
                                 GPIO_PIN_14 | GPIO_PIN_15;
    if(!g_bt_on)
        gpiod_analog_pins |= GPIO_PIN_2;  /* BLE关闭时PD2转Analog, BLE开启时保持INPUT */
    if (!lpuart_enabled)
    {
        gpiod_analog_pins |= (GPIO_PIN_8 | GPIO_PIN_9);  /* PD8=LPUART_TX, PD9=LPUART_RX */
    }
    gpio_mode_set(GPIOD, GPIO_MODE_ANALOG, GPIO_PUPD_NONE, gpiod_analog_pins);

    /* 6. GPIOF 配置
     *    PF1 未使用, 全部设为模拟
     */
    uint32_t gpiof_analog_pins = GPIO_PIN_0 | GPIO_PIN_1;
    gpio_mode_set(GPIOF, GPIO_MODE_ANALOG, GPIO_PUPD_NONE, gpiof_analog_pins);
}

// ===================== 控制 4G 模组 DTR 引脚 (PA0) =====================
// level: 1 = HIGH (允许模块休眠); 0 = LOW (强制唤醒)
void gpio_set_4g_dtr(uint8_t level)
{
    if(level)
    {
        gpio_bit_set(GPIOA, GPIO_PIN_0);
    }
    else
    {
        gpio_bit_reset(GPIOA, GPIO_PIN_0);
    }
}

// ===================== PD2 蓝牙连接状态引脚 =====================
// BLE模块(VG6328A-MS)连接成功后输出LOW, 未连接时HIGH
void ble_link_gpio_init(void)
{
    rcu_periph_clock_enable(RCU_GPIOD);
    gpio_mode_set(GPIOD, GPIO_MODE_INPUT, GPIO_PUPD_PULLUP, GPIO_PIN_2);
}

uint8_t ble_link_is_connected(void)
{
    return (gpio_input_bit_get(GPIOD, GPIO_PIN_2) == RESET) ? 1 : 0;
}
