xiaodi112/----home--valve/Pressure_Regulating_Box/Middle/downlink.c

/**
 * @file downlink.c
 * @brief MQTT下行指令处理模块 (优化版)
 * @details 负责接收处理云平台下发的MQTT消息, 执行对应指令并上报结果
 */

#include "downlink.h"
#include "report.h"
#include "ec800e.h"
#include "eeprom_config.h"
#include "calib_mode.h"
#include "valve_timing.h"
#include "app_config.h"
#include "threshold.h"
#include "sensor_record.h"
#include "PT_304_35.h"
#include "main.h"
#include "adc_bat.h"
#include "ota_app.h"
#include "valve.h"
#include "usart.h"
#include "delay.h"
#include "tim.h"
#include "json_builder.h"
#include "gd32l23x.h"
#include "leak_task.h"
#include <string.h>
#include <stdlib.h>
#include <stdio.h>
#include <stddef.h>

// ==================== 跨模块外部变量 (定义在main.c) ====================
extern uint8_t fourG_user_off;
extern uint8_t g_need_adc_sampling;
extern volatile uint8_t g_ch4_request;

// ==================== 模块内静态缓冲区 ====================
static char json_buf[1024];
static char ts_buf[32];
static JsonBuilder jb;

// ==================== 内部: JSON字段提取 ====================
static int extract_json_field(const char *buf, const char *field, char *out, uint16_t out_size)
{
    char *p;
    char *q;
    char *r;
    uint16_t len;

    out[0] = '\0';
    p = strstr(buf, field);
    if(!p) return 0;
    q = strchr(p + strlen(field), '"');
    if(!q) return 0;
    q++;
    r = strchr(q, '"');
    if(!r) return 0;
    len = (uint16_t)(r - q);
    if(len >= out_size) len = out_size - 1;
    memcpy(out, q, len);
    out[len] = '\0';
    return (len > 0) ? 1 : 0;
}

// 提取 "key","value":"xxx" 格式字段值 (平台 set 指令格式)
static int extract_key_value(const char *buf, const char *key, char *out, uint16_t out_size)
{
    char pat[64];
    char *p;
    char *q;
    uint16_t len;

    out[0] = '\0';
    snprintf(pat, sizeof(pat), "\"%s\",\"value\"", key);
    p = strstr(buf, pat);
    if(!p) return 0;
    p += strlen(pat);
    if(*p == ':') p++;
    if(*p != '"') return 0;
    p++;
    q = strchr(p, '"');
    if(!q) return 0;
    len = (uint16_t)(q - p);
    if(len >= out_size) len = out_size - 1;
    memcpy(out, p, len);
    out[len] = '\0';
    return (len > 0) ? 1 : 0;
}

// ==================== commandStr 映射表 ====================
typedef struct {
    const char *cmd_str;     // commandStr 值
    const char *id;          // 映射到 id_val
    const char *value;       // 固定值, NULL 表示从 raw_buf 提取
    const char *extract;     // 提取字段名 (value 为 NULL 时使用)
} CmdMap;

static const CmdMap s_cmd_map[] = {
    {"valve-open",        "valve",           "open",  NULL},
    {"valve-close",       "valve",           "close", NULL},
    {"get-pressure",      "get_pressure",    "1",     NULL},
    {"get-pressure1",     "get_pressure",    "1",     NULL},
    {"get-sim",           "get_sim",         "1",     NULL},
    {"get-ip",            "get_ip",          "1",     NULL},
    {"sensor-status",     "sensor_status",   "1",     NULL},
    {"restart",           "restart",         "1",     NULL},
    {"restart-off",       "restart_off",     "1",     NULL},
    {"4Gpower-off",       "4Gpower_off",     "1",     NULL},
    {"temp-get1",         "temp_status",     "1",     NULL},
    {"temp-get2",         "temp_status2",    "1",     NULL},
    {"LY06-get",          "LY06_get",        "1",     NULL},
    {"gas-get",           "gas_get",         "1",     NULL},
    {"laser-get",         "laser_get",       "",      NULL},
    {"laser-set",         "laser_set",       NULL,    "laser_switch"},
    {"msh-get",           "msh_get",         "",      NULL},
    {"msh-set",           "msh_set",         NULL,    "msh_threshold"},
    {"get-pressure2",     "get_pressure2",   "1",     NULL},
    {"threshold-get1",    "threshold",       "",      NULL},
    {"collectcycle-get",  "collect_cycle",   "",      NULL},
    {"report-get",        "report_cycle",    "",      NULL},
    {"window-get",        "window_pattern",  "",      NULL},
    {"abnormal-get",      "abnormal_close",  "",      NULL},
    {"abnormal2-get",     "abnormal2_close", "",      NULL},
    {"abnormal3-get",     "abnormal3_close", "",      NULL},
    {"first-ip-get",      "get_ip",          "1",     NULL},
    {"scend-ip-get",      "get_scend_ip",    "1",     NULL},
    {"valve-last-get",    "valve_last_order","1",     NULL},
    {"real-get",          "real_get",        "",      NULL},
    {"user-ip-get",       "user_ip_get",     "1",     NULL},
    {"MQTT-get",          "user_mqtt_get",   "1",     NULL},
    // 带参数提取的命令
    {"collectspeed-set",  "collect_cycle",   NULL,    "collect_once"},
    {"report-set",        "report_cycle",    NULL,    "report_once"},
    {"window-set",        "window_pattern",  NULL,    "window_pattern"},
    {"abnormal-set",      "abnormal_close",  NULL,    "abnormal_close"},
    {"abnormal2-set",     "abnormal2_close", NULL,    "abnormal2_close"},
    {"abnormal3-set",     "abnormal3_close", NULL,    "abnormal3_close"},
    {"first-ip-set",      "first_ip_set",    NULL,    "first-ip"},
    {"scend-ip-set",      "scend_ip_set",    NULL,    "scend-ip"},
    {"real-set",          "real_set",        NULL,    "real_enabled"},
    {"install-status-set","install_status_set",NULL,  "install_status"},
    {"user-ip-set",       "user_ip_set",     NULL,    "user-ip"},
    {"MQTT-set",          "user_mqtt_set",   "1",     NULL},
    // 阈值 set/get
    {"vpthreshold-set1",  "vpthreshold",     "1",     NULL},
    {"vpthreshold-get1",  "vpthreshold",     "",      NULL},
    {"Tthreshold-set",    "Tthreshold",      "1",     NULL},
    {"Tthreshold-get",    "Tthreshold",      "",      NULL},
    {"spupower-set",      "spupower",        "1",     NULL},
    {"spupower-get",      "spupower",        "",      NULL},
    {"delay-set",         "delay",           "1",     NULL},
    {"delay-get",         "delay",           "",      NULL},
    {"vpthreshold-set2",  "vpthreshold2",    "1",     NULL},
    {"vpthreshold-get2",  "vpthreshold2",    "",      NULL},
    {"Tthreshold-set2",   "Tthreshold2",     "1",     NULL},
    {"Tthreshold-get2",   "Tthreshold2",     "",      NULL},
    {"lcd-switch",        "lcd_switch",      NULL,    "lcd_switch"},
    // 阀门及定时开关
    {"valve-get",         "valve_status",    "1",     NULL},
    {"closeoropen-get",   "closeoropen",     "",      NULL},
    {"closeoropen-set",   "closeoropen",     "1",     NULL},
    // 表号
    {"table-get",         "table",           "",      NULL},
    {"table-set",         "table",           NULL,    "table"},
};
#define CMD_MAP_COUNT (sizeof(s_cmd_map) / sizeof(s_cmd_map[0]))

// ==================== 通用辅助函数 ====================

// 采集所有传感器
static void collect_all_sensors(void)
{
    PT304D_CollectAll((g_sensor_count >= 2) ? &g_sensor.raw2 : NULL, &g_sensor.raw);
}

// 双重JSON字段提取: 先查短格式 "key", 再查长格式 "key","value"
static int extract_field_dual(const char *raw_buf, const char *key_short,
                              const char *key_long, char *out, uint16_t out_size)
{
    char key1[48];
    char pat[64];
    snprintf(key1, sizeof(key1), "\"%s\"", key_short);
    if(extract_json_field(raw_buf, key1, out, out_size))
        return 1;
    snprintf(pat, sizeof(pat), "\"%s\",\"value\"", key_long);
    return extract_json_field(raw_buf, pat, out, out_size);
}

// 解析 "IP.port" 字符串 (按最后一个'.'分割)
static int parse_ip_port(const char *str, char *ip_out, uint16_t *port_out)
{
    char buf[MQTT_FIELD_MAX];
    char *dot;
    strncpy(buf, str, sizeof(buf) - 1);
    buf[sizeof(buf) - 1] = '\0';
    dot = strrchr(buf, '.');
    if(!dot) return 0;
    *dot = '\0';
    *port_out = (uint16_t)atoi(dot + 1);
    strncpy(ip_out, buf, MQTT_FIELD_MAX - 1);
    ip_out[MQTT_FIELD_MAX - 1] = '\0';
    return 1;
}

// 发布JSON并延时+反馈
static void publish_json_df(int fb_code)
{
    jb_end(&jb);
    EC801E_PublishRawJson(json_buf);
    trea_delay_ms(300);
    report_publish_feedback(fb_code);
}

// 仅发布JSON (无延时无反馈)
static void publish_json_only(void)
{
    jb_end(&jb);
    EC801E_PublishRawJson(json_buf);
}

// ==================== 阈值表驱动处理 ====================
typedef enum { FT_U8_BOOL, FT_FLOAT, FT_U16_CLAMP } ThrFieldType;
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
