xiaodi112/----home--valve/(commit log)

2026-06-18 Add project source: OTA Bootloader, App, BLE OTA协议文档
2026-07-18 v1.0: Pressure Regulating Box - household valve IoT controller
    - State machine: INIT->SLEEP->WAKEUP->COLLECT->UPLOAD/DOWNLINK/ALARM
    - MQTT over 4G (EC801E) with deep sleep + LPUART wakeup
    - M24M01 EEPROM persistent config (128KB I2C)
    - Dual PT304D pressure/temperature sensors
    - Motor-driven valve with limit switch detection
    - OTA firmware upgrade (BLE + 4G HTTP)
    - SLCD display, buzzer, LED indicators
    - Renamed: Household_valves_LPUART_OTA -> Pressure_Regulating_Box
2026-07-30 feat: 更新核心模块 - 传感器、4G、阈值、阀门等模块优化
2026-08-01 update: 优化下行指令处理、OTA升级、阈值检测及按键逻辑
2026-08-07 chore: 恢复最初工程内容并分层重构 - my_Library 拆分为 App/Middle/BSP/Drivers (纯文件移动, 逻辑不变)
    代码逻辑回退到最初工程(3-now_one)内容, 撤销此前全部功能改动(阀门/状态类/功耗插桩等)
    工程重构: my_Library 平铺目录按层迁移 - App(业务: valve/buzzer/led/lcd_ui), Middle(协议配置: downlink/threshold/eeprom/sensor_buffer/json/ota), BSP(板级: delay/tim/usart/mygpio/adc/motor/slcd/systick), Drivers(外设: ec800e/PT_304_35/i2c/m24m01/ble_ota)
    Keil 工程: my_Library 分组拆为四层分组, IncludePath 与文件路径同步更新; 源码文件内容零改动(include 均裸文件名, 靠 IncludePath 解析)
    验证: Keil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
2026-08-07 feat: EEPROM 支持 AT24C64/M24M01 双芯片宏编译选择
    新增 Drivers/at24c64.c/h: AT24C64(8KB, 32B页, 设备地址0xA0) 驱动, 接口与 M24M01 对齐(Read/Write/WriteByte/WaitReady/Test), 共用 bus0(PC0/PC1)+PD4 电源管理
    app_config.h 新增 EEPROM_DRV_M24M01 / EEPROM_DRV_AT24C64 编译宏(默认 M24M01, 必须且只能启用一个)
    eeprom_config.c / eeprom_history.c: 通过 EE_READ/EE_WRITE/EE_WRITE_BYTE 宏选择驱动, 原 M24M01 逻辑与地址布局不变
    地址布局 0x000~0x1FFF(配置2KB+历史6KB) 与 AT24C64 8KB 容量完全兼容; Keil 工程 Drivers 组加入 at24c64.c
    验证: M24M01 与 AT24C64 两种宏配置均构建 0 Error 2 Warning
2026-08-07 feat: 历史数据存储重构 - 上电不清空/分芯片布局/M24 128KB+静态侧漏预留/删RAM缓冲
    上电不清空: ee_hist_init 仅当管理头无效(magic/CRC/范围)才格式化, 掉电保留历史; 上报完成清空与失败保留续传逻辑保持
    分芯片布局: AT24C64 保持 2KB配置+6KB历史(191条); M24M01 4KB配置 + 静态侧漏预留区(600条x32B @0x1000, 宏 EE_SIDELEAK_*, 功能后续实现) + 历史区 0x5B00~0x1FFFF(3367条)
    M24M01 驱动扩展至 128KB: A16 编码进设备地址字节 bit1, 高地址字节掩码 A15~A8(&0xFF), TOTAL_SIZE 131072
    删除废弃 RAM 缓冲 sensor_buffer.c/h, SensorRecord_t 迁至新头 sensor_record.h (main/ec800e/eeprom_history/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
2026-08-07 feat: dot(点模式)上报改为多点方案 - 24小时位图 dottime_mask[3]
    窗口配置 g_window.dottime(单点) 改为 g_window.dottime_mask[3](24小时位图), 支持一天多个整点上报, 如 dottime=08,12,14,18,20
    eeprom_config: 新增 window_dottime_clear/set/hit/first/from_str/to_str 位图工具; EE_ADDR_WINDOW_DOTTIME_MASK(0x2E0,3B) 存储位图, 0x21A 保留旧单点兼容(空位图时迁移旧值)
    main.c: dot 上报调度按位图判断, 已上报位图 dot_uploaded_mask[3] + 跨日重置 dot_uploaded_day
    downlink/config 下发与打印/上报均支持多值字符串格式
    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
2026-08-07 feat: 上报按传感器个数裁剪 - 单传感器2字段/双传感器4字段
    主平台历史上报 EC801E_PublishSingleRecord: 按 g_sensor_count 选模板, 单传感器只发 temp/pressure, 双传感器发 temp/temp2/pressure/pressure2
    用户端负载 ly_build_payload(实时+历史共用): 同样按 count 裁剪 temp2/pressure2 字段
    用户端实时上报 UserMqtt_PublishSensorData: p2/t2/fault bit2 按 g_sensor_count>=2 门控, 避免单传感器 raw2.err=0 误判有效
    高效实现: 每处一次整数判断 + 双模板单次 snprintf, 无拼接循环; 不改 EEPROM 记录结构
    验证: M24M01 与 AT24C64 两种宏配置均构建 0 Error 0 Warning
2026-08-07 fix: 上电首次上报 EC801E_PublishSensorData 按传感器个数裁剪
    首次上报(上电初始化 main.c 2505 / sensor_read / FullUpload) 走 EC801E_PublishSensorData, 此前固定 4 字段且直接读 g_sensor.raw2, 单传感器时仍上报第二路
    修复: 按 g_sensor_count 选模板, 单传感器只发 temp/pressure, 双传感器发 4 字段; 单传感器不再读 raw2
    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
2026-08-07 fix: g_sensor_count 全局初始值跟随 APP_DEFAULT_SENSOR_COUNT(原硬编码2)
    根因: g_sensor_count 初始值硬编码 2, APP_DEFAULT_SENSOR_COUNT 只在 EEPROM 无有效配置时生效; 设备 EEPROM 存过 sensor_count=2 时运行时仍为 2, 导致所有上报裁剪判断走双路
    修复: 初始值改为 APP_DEFAULT_SENSOR_COUNT, 新设备/清 EEPROM 后默认按产品配置(单路)
    注意: 已存 EEPROM 的旧值需设备端重新下发 sensor_count=1 或清 EEPROM 才覆盖(运行时以 EEPROM 为准)
    验证: M24M01 构建 0 Error 0 Warning
2026-08-07 feat: 传感器数量改为纯编译期配置 - 不走EEPROM, 默认双路
    g_sensor_count 完全由 APP_DEFAULT_SENSOR_COUNT 宏决定(默认2双路), 单路产品改代码宏=1
    删除: EEPROM 读(602)/写(697)/非法回退(612) 与 debug sensor_count= 命令; 删除平台 sensor_count_set 命令映射与处理
    运行时不再受 EEPROM 旧值/平台命令影响; 上报/采集/阈值按编译期传感器数运行
    EE_ADDR_SENSOR_COUNT 地址宏保留(兼容布局, 不再读写)
    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
2026-08-07 feat: abnormal_close 命令增加平台反馈 - 获取成功28/配置成功29
    异常关阀查询(abnormal_get): 上报后 feedback=28 异常关阀获取成功; 异常关阀配置(abnormal_set): 上报后 feedback=29 异常关阀配置成功
    同时修复此前误删的 lcd_switch 下行处理分支(已恢复)
    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
2026-08-07 feat: 定时开关阀最高优先级 - 上报/4G发送中立即打断执行
    新增 g_timing_pending/g_timing_alarm_set: 定时阀门闹钟(RTC)到点由 ISR 置 pending, 普通闹钟不置位
    EC_SendCmd 等待循环检查 pending -> 返回新增 EC_PREEMPT(≤30ms 内打断任意 MQTT/AT 发送); EC_SendCmdRetry/ec_pubex_send/PublishRawJson 逐级传递
    do_upload 逐条循环: 每条记录前 vtiming_check_now(时间判断兜底), EC_PREEMPT 时执行阀门后重发当前记录
    主循环顶部 vtiming_check_now 兜底; 实时/非实时模式均覆盖, 当日定时动作不再被上报/阻塞遗忘
    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
2026-08-07 fix: 初次上电 LCD 电压显示错误 - 先采电压再刷屏, last_normal_voltage 初始 3.6V
    根因: 上电时 lcd_ui_refresh 在 sensor_sample_voltage 之前执行, 传入的 g_sensor.voltage 为全局零初始化 0V, 开机第一屏显示 0V
    修复: 调整顺序为先 sensor_sample_voltage 再 lcd_ui_refresh; g_sensor.last_normal_voltage 初始 3.6f 作为 ADC 无效回退
    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
2026-08-13 update: 工程分层架构全面更新 - BSP/Drivers/Middle层重构, LCD/阀门/EEPROM/4G优化, 新增.gitattributes与引脚说明文档
2026-08-30 update: 工程架构与功能更新 - BSP新增电源/唤醒/输出模块, 新增CH4甲烷传感器与软件I2C驱动, 配置存储拆分(config_store/config_policy), 新增数据上报与阀门定时模块
    删除旧 i2c_eeprom/i2c_sensor 驱动及 LCD/电路图/数据交互图片, 移除 BLE_OTA_Protocol_Spec.md, 更新工程说明文档
    .gitattributes 由 GBK 工作树编码改为 UTF-8, .gitignore 忽略 .vscode 与构建日志
2026-09-05 feat: 双端传感器/激光甲烷独立异常关阀策略(abnormal2/3)与多项功能完善
    - 进气/出气端分别按 abnormal_close/abnormal2_close 策略自动关阀, 激光甲烷独立 abnormal3_close 开关; 新增 abnormal2/3 查询与配置下发
    - 4G: 冷启动统一由 InitAndConnect 内含 V4G_EN+PWRKEY 时序, 弱信号断电流程与周期上报防重优化
    - restart_off 不再先关阀直接重启; 旧 docs 目录清理(文档已迁移至 Pressure_Regulating_Box/Docs)
2026-10-14 feat: 三灯状态灯/PA4按键手势 + 零点基准/未安装校零/静态测漏模块 + 双路传感器
    - 按键 PA4(Btn1): EXTI4 下降沿唤醒 + 最小初始化快速路径; 短按三灯提示, 长按 8s 零点重校手势
    - 三路状态灯(App/led): 检修/阀关/换电池长亮真源 + 按键有效提示/校准失败提示(非阻塞, 秒级闹钟)
    - 新增 Middle/zero_cal: 大气基准双槽管理, 上电只读不改, 无基准时默认值 + 一次自动采集
    - 新增 Middle/calib_mode: 未安装自动校零(采样节拍/自动锁定/安装事件一次性上报)
    - 新增 Middle/leak_task + leak_store: 静态测漏任务(独立 STATE_LEAK, 暂存区/5 条一包上报/回执清除)
    -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
2026-10-14 docs: 新增静态测漏实现说明与平台测漏 MQTT 协议文档; 忽略 build_rebuild.log
